sternlabs/current-monitor/doc/Screw Terminal 7797.PDF

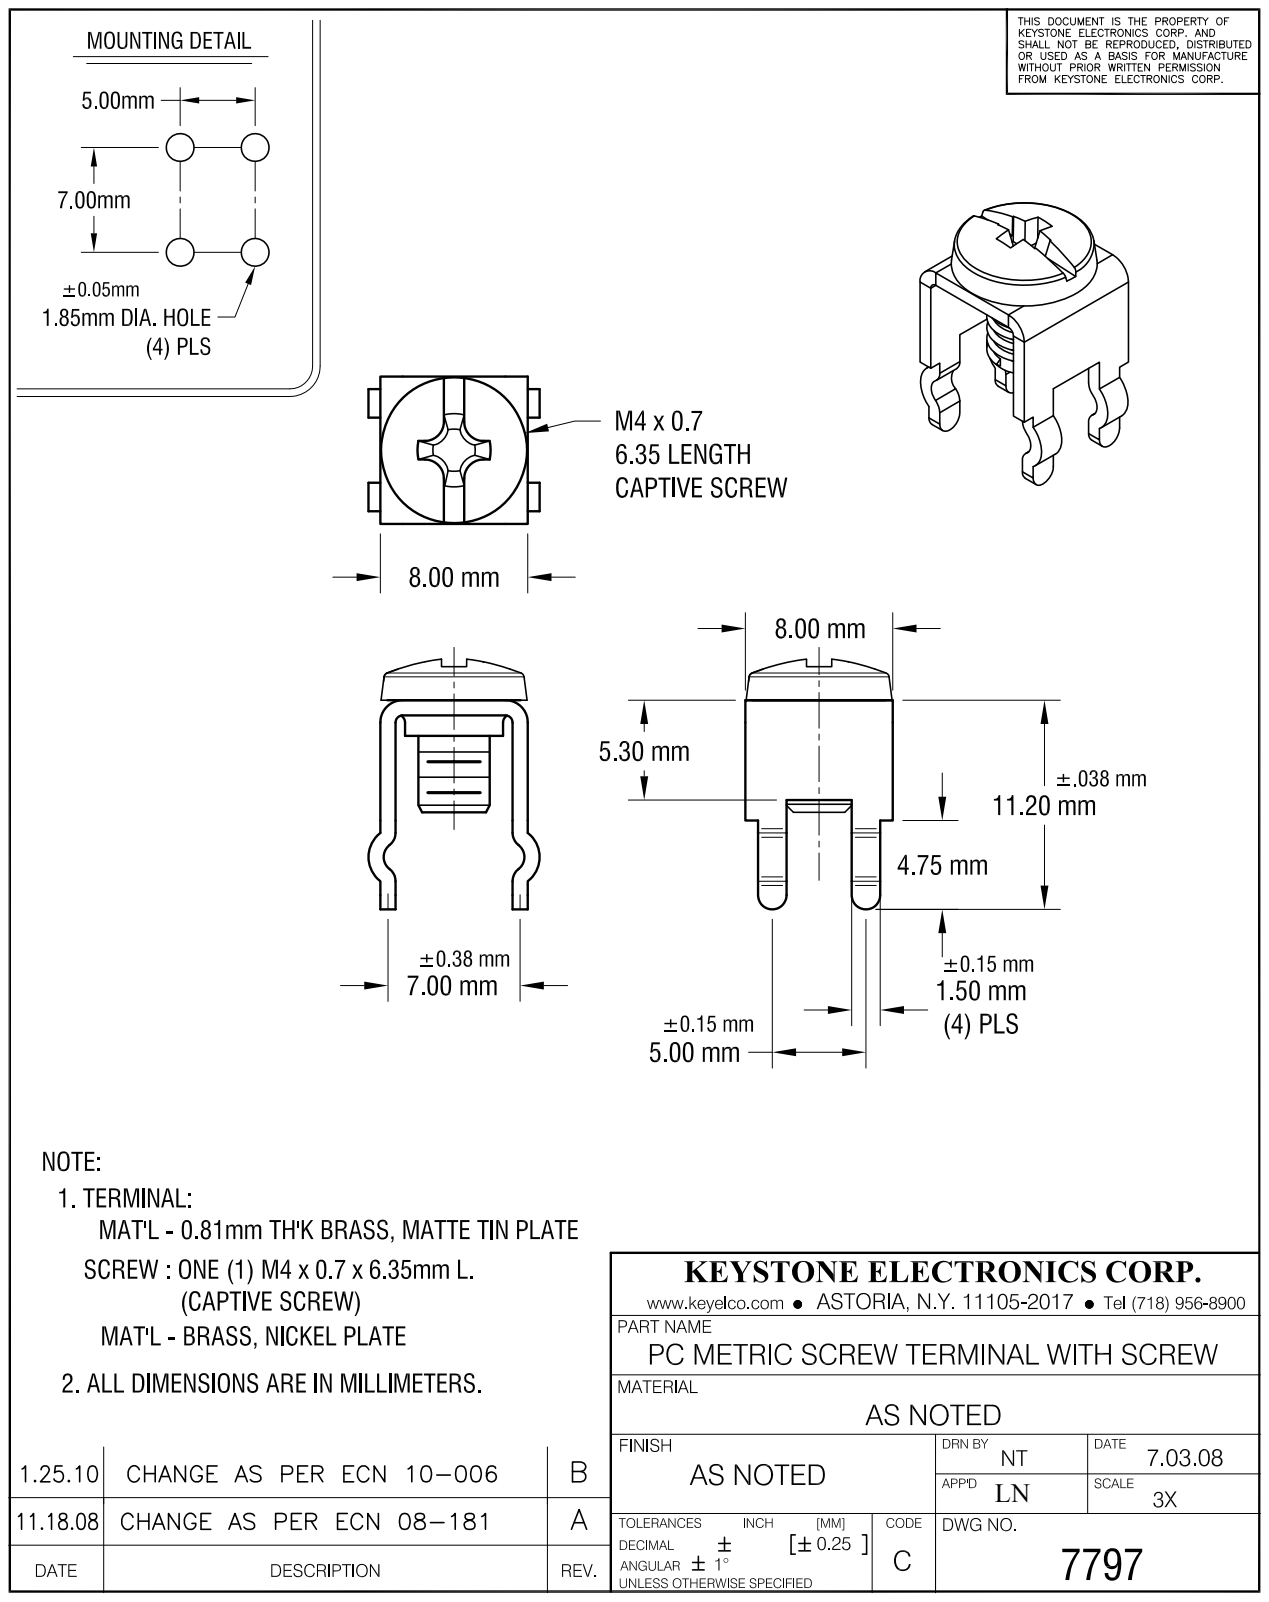
[picture p1: page 1]
