sternlabs/current-monitor/current-monitor.kicad_pcb

## KiCad design current-monitor.kicad_pcb (2015-10-16)

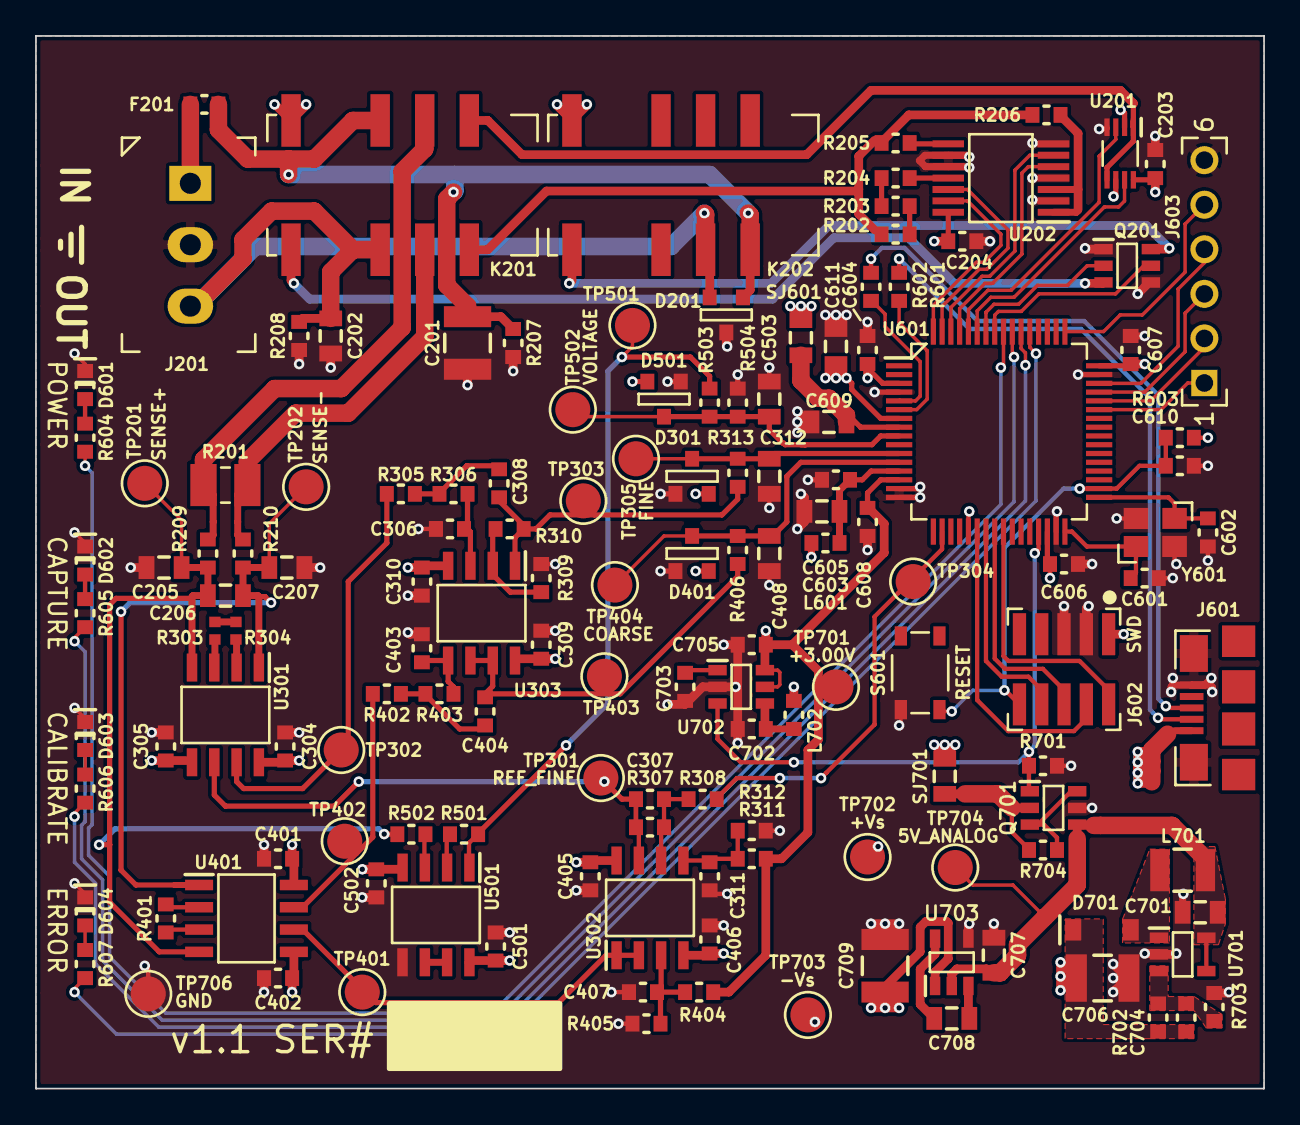
[picture p2: board current-monitor.kicad_pcb from above]

Board: 4 copper layers, 70.0 x 60.0 mm, 143 parts (0 on the bottom side), 93 nets.

Parts:
C201, C706, C709: 10u; SMD-3225
C202, C603, C609, C611, C701, C707, C708: 2.2u; SMD-2012
C203, C204, C304, C305, C309, C310, C401, C402, C405, C406, C501, C502, C604, C605, C606, C607, C608, C610, C702, C705: 0.1u; SMD-1608
C205, C207, C312, C408, C503: 4.7n; SMD-2012
C206: 47n; SMD-2012
C306, C308, C404: 1n; SMD-1608
C307: 470p; SMD-1608
C311, C407, C703: 10n; SMD-1608
C403: 120p; SMD-1608
C601, C602: 8p; SMD-1608
C704: 134p; SMD-1608
D201: MMBZ15VALT1G; SOT-23
D301, D401, D501: BAS40-04; SOT-23
D601: POWER; SMD-1608-LED
D602: ERROR; SMD-1608-LED
D603: CAPTURE; SMD-1608-LED
D604: CALIBRATE; SMD-1608-LED
D701: MBR0530; SOD-123
F201: 2A; SMD-1608
J201: CONN-3; TERM-3-3.5-PTH
J601: USB-MICROB; USB-MICRO-B-FCI-10118192
J602: SWD; CONN-2x5-1.27-SMT
J603: CONN-6; CONN-6-2.54-1.0-PTH
K201, K202: RELAY-DPDT-EE2-SPLIT; RELAY-EE2-NU
L601, L702: MPZ1608B471ATA00; SMD-1608
L701: 33u 0.2A; SMD-2520
Q201: DRDC3105E6; SOT-23-6
Q701: DMG6601LVT; SOT-23-6
R201: 0.33; KRL2012D
R202, R203, R204: 470k 0.05%; SMD-1608
R205: 16k 0.05%; SMD-1608
R206: 150 0.05%; SMD-1608
R207, R208: 470k; SMD-1608
R209, R210: 10; SMD-1608
R303, R304: 0.33; SMD-1005
R305: 4.9k; SMD-1608
R306: 2.36k; SMD-1608
R307: 12k; SMD-1608
R308, R312, R603: 10k; SMD-1608
R309: 4.7k; SMD-1608
R310: 9.4k; SMD-1608
R311: 27k; SMD-1608
R313, R406: 971; SMD-1608
R401: 1.74k; SMD-1608
R402: 6.66k; SMD-1608
R403: 14.5k; SMD-1608
R404: 67k; SMD-1608
R405: 499; SMD-1608
R501, R502: 20k; SMD-1608
R503: 4k; SMD-1608
R504, R604, R605, R606, R607: 1k; SMD-1608
R601, R602: 33; SMD-1608
R701, R704: 51k; SMD-1608
R702: 149k; SMD-1608
R703: 13.3k; SMD-1608
S601: RESET; TACT-4632
SJ601: SENSE_MCU; SMD-2012
SJ701: SENSE_ANALOG; SMD-2012
TP201: SENSE+; TESTPOINT-2.0
TP202: SENSE-; TESTPOINT-2.0
TP301: REF_FINE; TESTPOINT-2.0
TP302: FINE_LOW; TESTPOINT-2.0
TP303: FINE_UNCLAMPED; TESTPOINT-2.0
TP304: REF_ADJUST; TESTPOINT-2.0
TP305: FINE; TESTPOINT-2.0
TP401: REF_COARSE; TESTPOINT-2.0
TP402: COARSE_LOW; TESTPOINT-2.0
TP403: COARSE_UNCLAMPED; TESTPOINT-2.0
TP404: COARSE; TESTPOINT-2.0
TP501: VOLTAGE_RAW; TESTPOINT-2.0
TP502: VOLTAGE; TESTPOINT-2.0
TP701: +3.00V; TESTPOINT-2.0
TP702: +Vs; TESTPOINT-2.0
TP703: -Vs; TESTPOINT-2.0
TP704: 5V_ANALOG; TESTPOINT-2.0
TP706: GND; TESTPOINT-2.0
U201: FSA1259A; VFSOP-8
U202: MAX4737EUD; TSSOP-14
U301: AD8429A; SOIC-8-N
U302, U501: TL032C; SOIC-8-N
U303: LM833; SOIC-8-N
U401: INA826; SOIC-8-N
U601: K22F-64LQFP; QFP-64-10x10
U701: LM27313; SOT-23-5
U702: MAX6070; SOT-23-6
U703: TPS6040x; SOT-23-5
Y601: 10MHz; OSC3225

Connections:
+3.00V: C608.1, C705.1, R311.2, R404.2, TP701.TP, U201.6, U601.14, U702.5, U702.6
+3V3: C604.1, C606.1, C607.1, C611.1, D301.2, D401.2, D501.2, J602.1, L601.1, R603.1, U601.3, U601.7, U601.21, U601.30, U601.48
+5V: C203.1, C204.1, J601.1, K201.1, K202.1, L702.1, SJ601.1, SJ701.1, U201.2, U201.8, U202.14
+Vs: C304.1, C309.1, C401.1, C405.1, C501.1, C704.1, C706.1, D701.C, R702.1, TP702.TP, U301.8, U302.8, U303.8, U401.8, U501.8
-Vs: C305.1, C310.1, C402.1, C406.1, C502.1, C709.1, TP703.TP, U301.5, U302.4, U303.4, U401.5, U501.4, U703.1
/Current Sense Coarse Range/COARSE_UNCLAMPED: C404.2, R406.1, TP403.TP, U303.6, U303.7
/Current Sense Coarse Range/COARSE_UNFILTERED: R402.1, TP402.TP, U401.7
/Current Sense Coarse Range/REF_COARSE: TP401.TP, U302.1, U302.2, U401.6
/Current Sense Coarse Range/SENSE_COARSE: C408.1, D401.3, R406.2, TP404.TP, U601.12
/Current Sense Fine Range/FINE_UNCLAMPED: C308.2, R310.2, R313.1, TP303.TP, U303.1
/Current Sense Fine Range/REF_ADJUST: R308.2, TP304.TP, U601.18
/Current Sense Fine Range/REF_FINE: C307.1, R307.1, TP301.TP, U301.6, U302.7
/Current Sense Fine Range/SENSE_FINE: C312.1, D301.3, R313.2, TP305.TP, U601.11
/In/Out, Shunt, Calibration/CALIBRATE_3V: U201.3, U601.60
/In/Out, Shunt, Calibration/CALIBRATE_3uA: U202.12, U601.63
/In/Out, Shunt, Calibration/CALIBRATE_5V: U201.7, U601.59
/In/Out, Shunt, Calibration/CALIBRATE_30mA: U202.13, U601.64
/In/Out, Shunt, Calibration/CALIBRATE_30mA_2: U202.5, U601.61
/In/Out, Shunt, Calibration/CALIBRATE_300uA: U202.6, U601.62
/In/Out, Shunt, Calibration/IN: C201.1, D201.1, F201.1, K201.3, K202.8, R207.1
/In/Out, Shunt, Calibration/OUT: C202.1, D201.2, J201.3, K201.10, K202.9, R208.1
/In/Out, Shunt, Calibration/RELAY_CALIBRATE: Q201.2, U601.58
/In/Out, Shunt, Calibration/RELAY_INOUT_SHORT: Q201.5, U601.57
/MCU/5V_MCU: C609.1, SJ601.2, U601.8
/MCU/GPIO0: J603.1, U601.43
/MCU/GPIO1: J603.2, U601.44
/MCU/GPIO2: J603.3, U601.45
/MCU/GPIO3: J603.4, U601.46
/MCU/GPIO4: J603.5, U601.49
/MCU/LED_CALIBRATE: R606.1, U601.54
/MCU/LED_CAPTURE: R605.1, U601.55
/MCU/LED_ERROR: R607.1, U601.53
/MCU/LED_POWER: R604.1, U601.56
/MCU/SENSE_VOLTAGE: C503.1, D501.3, R503.2, R504.1, TP502.TP, U601.9
/MCU/SWD_CLK: J602.4, U601.22
/MCU/SWD_DIO: J602.2, U601.25
/MCU/UART_RX: J602.8, U601.23
/MCU/UART_TX: J602.6, U601.24
/MCU/USB_DM: J601.2, R601.1
/MCU/USB_DP: J601.3, R602.1
/MCU/VS_ENABLE: Q701.1, R701.1, U601.29, U702.3
/MCU/~RESET: C610.1, J602.10, R603.2, S601.3, U601.34
/Power Supply/5V_ANALOG: C701.1, C707.1, L701.1, Q701.4, TP704.TP, U701.4, U701.5, U703.2
/Power Supply/DC_FB: C704.2, R702.2, R703.1, U701.3
/Power Supply/DC_SW: D701.A, L701.2, U701.1
/Sense Voltage/VOLTAGE_RAW: R501.1, R503.1, TP501.TP, U501.1
COM: C201.2, C202.2, C203.2, C204.2, C205.2, C207.2, C304.2, C305.2, C306.2, C309.2, C310.2, C311.2, C312.2, C401.2, C402.2, C403.2, C405.2, C406.2, C407.2, C408.2, C501.2, C502.2, C503.2, C601.2, C602.2, C603.2, C604.2, C605.2, C606.2, C607.2, C608.2, C609.2, C610.2, C611.2, C701.2, C702.2, C703.2, C705.2, C706.2, C707.2, C709.2, D201.3, D301.1, D401.1, D501.1, D601.C, D602.C, D603.C, D604.C, J201.2, J601.5, J601.SHIE, J602.3, J602.5, J603.6, Q201.1, Q201.4, Q701.5, R207.2, R208.2, R309.2, R312.2, R405.2, R504.2, R701.2, R703.2, S601.1, TP706.TP, U201.4, U202.2, U202.4, U202.7, U202.9, U202.10, U501.5, U601.4, U601.15, U601.16, U601.31, U601.47, U701.2, U702.2, U703.4, Y601.2, Y601.4
unnamed: C306.1, R306.2, U303.3
unnamed: C307.2, R307.2, R308.1, U302.6
unnamed: C308.1, R305.2, R306.1
unnamed: C311.1, R311.1, R312.1, U302.5
unnamed: C403.1, R403.2, U303.5
unnamed: C404.1, R402.2, R403.1
unnamed: C407.1, R404.1, R405.1, U302.3
unnamed: C601.1, U601.32, Y601.1
unnamed: C602.1, U601.33, Y601.3
unnamed: C603.1, C605.1, L601.2, U601.13
unnamed: C702.1, L702.2, U702.4
unnamed: C703.1, U702.1
unnamed: C708.1, U703.3
unnamed: C708.2, U703.5
unnamed: D601.A, R604.2
unnamed: D602.A, R605.2
unnamed: D603.A, R606.2
unnamed: D604.A, R607.2
unnamed: F201.2, J201.1
unnamed: K201.4, R201.1, R209.1
unnamed: K201.5, U201.1, U201.5
unnamed: K201.8, R202.1, R205.1, R206.1
unnamed: K201.9, R201.2, R210.1
unnamed: K201.12, Q201.3
unnamed: K202.12, Q201.6
unnamed: Q701.2, R704.1, SJ701.2
unnamed: Q701.3, Q701.6, R704.2
unnamed: R202.2, R203.1
unnamed: R203.2, R204.1
unnamed: R204.2, U202.11
unnamed: R205.2, U202.8
unnamed: R206.2, U202.1, U202.3
unnamed: R303.1, U301.3
unnamed: R303.2, R304.1
unnamed: R304.2, U301.2
unnamed: R305.1, TP302.TP, U301.7
unnamed: R309.1, R310.1, U303.2
unnamed: R401.1, U401.3
unnamed: R401.2, U401.2
unnamed: R501.2, U501.2
unnamed: R502.2, U501.3
unnamed: R601.2, U601.6
unnamed: R602.2, U601.5
unnamed: U501.6, U501.7
SENSE+: C205.1, C206.1, R209.2, R502.1, TP201.TP, U301.4, U401.4
SENSE-: C206.2, C207.1, R210.2, TP202.TP, U301.1, U401.1
