sternlabs/current-monitor/(threads)

Thread 1 (2015-12-20):

470k does not exist in 0.05%, 1608

corecode, 2015-12-20:
Resistors R202, R203, R204 are 1608, but 0.05% tolerance does not exist in 1608.  Temporary fix: use 0.1% tolerance resistors.

Thread 2 (2015-12-26):

R201 footprint too large

corecode, 2015-12-26:
During reflow R201 was pulled to one side.

See:
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

Thread 3 (2015-12-26):

Lightpipe holes a bit too small

corecode, 2015-12-26:
Lightpipes do not sit flush:

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

corecode, 2016-06-09:
fixed in 1.3

Closed 2016-06-09.

Thread 4 (2015-12-27):

5V and 3V are shorted during boot because U201 has floating inputs

corecode, 2015-12-27:
U201 needs pull down resistors.

corecode, 2016-06-09:
addressed in 1.3

Closed 2016-06-09.

Thread 5 (2015-12-28):

Fine-range Sallen-Key filter oscillates

corecode, 2015-12-28:
Need to pick other values to prevent instability.  See: http://sim.okawa-denshi.jp/en/OPseikiLowkeisan.htm

```
R1=￼51.1kΩ	C1=￼220pF
R2=10k￼Ω 	C2=￼680pF
R3=￼4.65kΩ
R4=￼12kΩ
```
seems reasonable at first sight.

corecode, 2015-12-29:
Also consider using the one unused TL032 to liberate the LM833 to form a higher order filter for the  coarse range (#7).

Thread 8 (2015-12-30):

EE2 relay footprint inverterd

corecode, 2015-12-30:
Drawn flipped - PDF shows bottom view, pinout drawn same as top view.

corecode, 2016-06-09:
fixed in 1.3

Closed 2016-06-09.

Thread 9 (2016-01-11):

Kinetis DAC needs VREF_OUT pin connected to external reference

corecode, 2016-01-11:
The DAC can either use `VREF_OUT` (`DACRFS=0`) or `VDDA` (`DACRFS=1`) as voltage reference. Route external voltage reference to `VREF_OUT`, so that the DAC can use the reference.

corecode, 2016-06-09:
addressed in 1.3

Closed 2016-06-09.

Thread 10 (2016-04-10):

Input protection insufficient

corecode, 2016-04-10:
Fine range in-amp needs better input protection.  Without power, it draws >10mA at 5V input voltage.

Protection resistors add noise.  Maybe invert relay logic to be in short + input circuit detached when no power is applied?

Thread 11 (2016-06-01):

V- charge pump is noisy

corecode, 2016-06-01:
Switch to TPS60403 (fixed 250kHz). [LM2776](http://www.ti.com/lit/ds/symlink/lm2776.pdf) (2MHz) seems unsuitable because of automatic pulse skipping during low load.

corecode, 2016-06-09:
going with TPS60403 in 1.3

Closed 2016-06-09.

Thread 12 (2016-06-04):

Validate boost converter layout and power delivery

corecode, 2016-06-04:
The 5V supply trace seems to be radiating at 1.5MHz.  Investigate use of ferrite, larger reservoir cap, larger 5V trace.
