sternlabs/current-monitor/(commit log)

2015-08-18 start schematic
    [current-monitor.sch, mcu.sch, power.sch, sense-coarse.sch, sense-fine.sch]
2015-08-21 close to functional
    [current-monitor.kicad_pcb, current-monitor.sch, mcu.sch, power.sch, sense-coarse.sch, sense-fine.sch, sense-voltage.sch]
2015-08-23 more layout
    [current-monitor.kicad_pcb, mcu.sch, power.sch, sense-coarse.sch, sense-fine.sch, sense-voltage.sch]
2015-08-24 add ltc6102
    [current-monitor.sch, mcu.sch, power.sch, sense-coarse.sch, sense-fine.sch, sense-voltage.sch]
2015-08-25 add calibration
    [current-monitor.sch, mcu.sch, power.sch, sense-coarse.sch, sense-fine.sch, sense-voltage.sch, shunt.sch]
2015-08-25 remove ltc6102 again
    [mcu.sch, power.sch, sense-coarse.sch, sense-fine.sch, sense-voltage.sch, shunt.sch]
2015-08-25 shuffle, prettify schematic
    [current-monitor.sch, mcu.sch, power.sch, sense-coarse.sch, sense-fine.sch, sense-voltage.sch, shunt.sch]
2015-08-25 shuffle sheet numbers
    [current-monitor.sch, mcu.sch, power.sch, sense-coarse.sch, sense-fine.sch, sense-voltage.sch, shunt.sch]
2015-08-25 renumber pmos
    [shunt.sch]
2015-08-25 renumber, add calibration relays
    [mcu.sch, power.sch, sense-coarse.sch, sense-fine.sch, sense-voltage.sch, shunt.sch]
2015-08-25 renumber pcb
    [current-monitor.kicad_pcb, power.sch]
2015-08-25 use screw terminals
    [current-monitor.kicad_pcb, current-monitor.sch, mcu.sch, power.sch, sense-coarse.sch, sense-fine.sch, sense-voltage.sch, shunt.sch]
2015-09-03 add analog switches
    [current-monitor.sch, mcu.sch, power.sch, sense-coarse.sch, sense-fine.sch, sense-voltage.sch, shunt.sch]
2015-09-03 add current sense jumpers
    [current-monitor.sch, mcu.sch, power.sch]
2015-09-08 full design
    [current-monitor.kicad_pcb, current-monitor.sch, mcu.sch, power.sch, sense-coarse.sch, sense-fine.sch, sense-voltage.sch, shunt.sch]
2015-09-08 adjust mask clearance
    [current-monitor.kicad_pcb]
2015-09-11 zone connections
    [current-monitor.kicad_pcb]
2015-09-11 move Q201 to the east
    [current-monitor.kicad_pcb, mcu.sch]
2015-09-13 use rfi filter for all inputs
    [current-monitor.kicad_pcb, current-monitor.sch, mcu.sch, power.sch, sense-coarse.sch, sense-fine.sch, sense-voltage.sch, shunt.sch]
2015-09-13 case size pass
    [current-monitor.kicad_pcb, mcu.sch, power.sch, sense-coarse.sch, sense-fine.sch, sense-voltage.sch, shunt.sch]
2015-09-15 change footprints
    [sense-coarse.sch, sense-fine.sch]
2015-09-15 adapt layout
    [current-monitor.kicad_pcb]
2015-09-15 add maxima filter calculations
2015-09-15 change fill
    [current-monitor.kicad_pcb]
2015-09-15 board size mod
    [current-monitor.kicad_pcb]
2015-09-15 layout finish
    [current-monitor.kicad_pcb]
2015-09-15 move SJ for mcu
    [current-monitor.kicad_pcb]
2015-09-15 tidy up power plane
    [current-monitor.kicad_pcb]
2015-09-15 slight track cleanup
    [current-monitor.kicad_pcb]
2015-09-16 fix BOM number
    [current-monitor.kicad_pcb, power.sch, shunt.sch]
2015-09-16 adjust filter calcs for 20kHz
2015-09-18 change power supply
    [current-monitor.kicad_pcb, current-monitor.sch, mcu.sch, power.sch, sense-coarse.sch, sense-fine.sch, sense-voltage.sch, shunt.sch]
2015-09-18 pcb cleanup
    [current-monitor.kicad_pcb]
2015-09-18 remove dangling via
    [current-monitor.kicad_pcb]
2015-09-18 move via
    [current-monitor.kicad_pcb]
2015-09-18 thermal relief on input gnd
    [current-monitor.kicad_pcb]
2015-09-21 remove power from boost regulator
    [current-monitor.kicad_pcb, current-monitor.sch, mcu.sch, power.sch, sense-coarse.sch, sense-fine.sch, sense-voltage.sch, shunt.sch]
2015-09-25 venable switches vref as well
    [current-monitor.kicad_pcb, power.sch]
2015-09-28 add 3d shapes
    [current-monitor.kicad_pcb]
2015-10-16 add forgotten via
    [current-monitor.kicad_pcb]
