sternlabs/current-monitor/(notices)

Notices in the files:
sense-coarse.sch:
(c) 2015 Simon Schubert
